shyan-shah/robot-penguin/CAD/renders/back.png

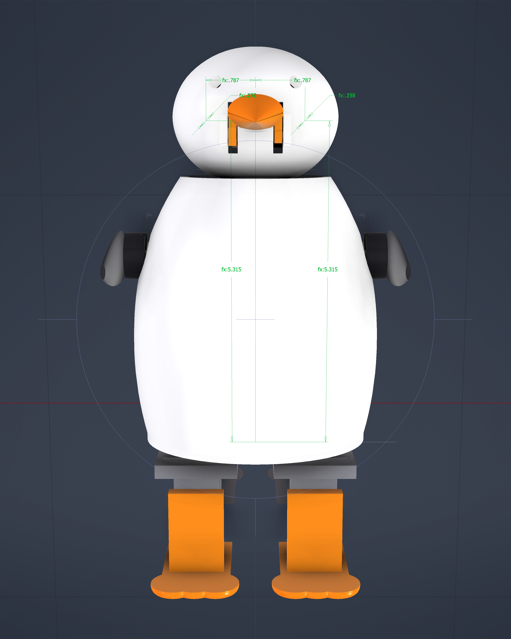
CAD/renders/back.png
