shyan-shah/robot-penguin/CAD/renders/base_plate_front.png

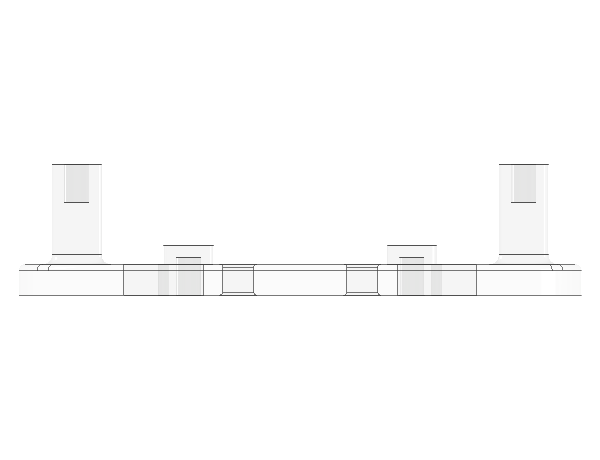
CAD/renders/base_plate_front.png
