shyan-shah/robot-penguin/CAD/renders/base_plate_iso.png

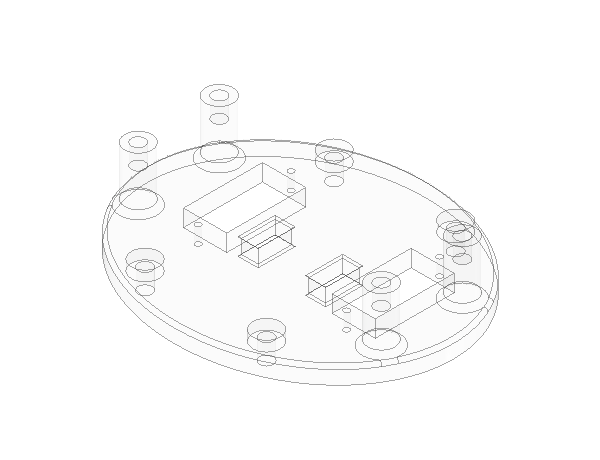
CAD/renders/base_plate_iso.png
