shyan-shah/robot-penguin/CAD/renders/base_plate_top.png

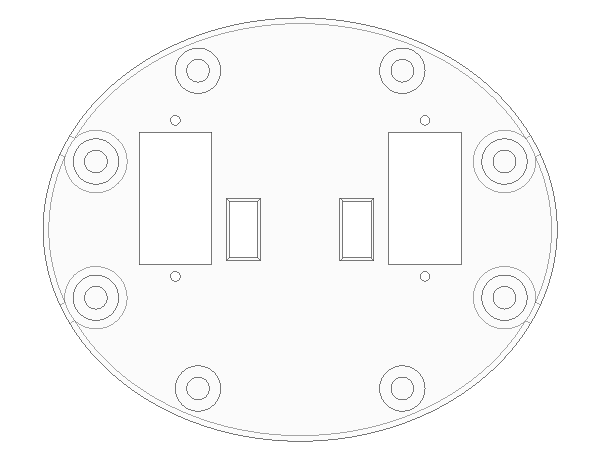
CAD/renders/base_plate_top.png
