shyan-shah/robot-penguin/CAD/renders/body_front_inside.png

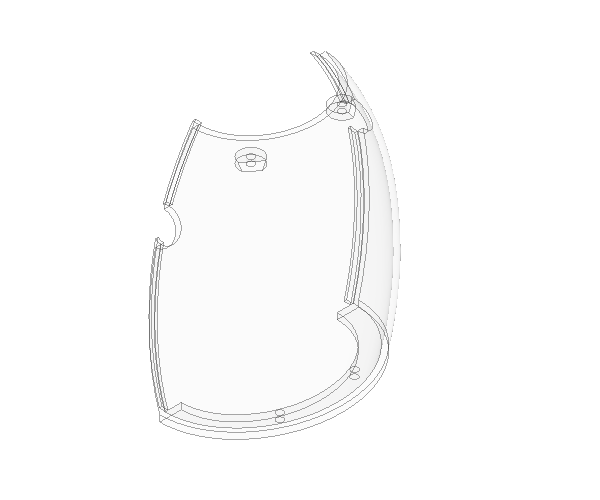
CAD/renders/body_front_inside.png
