shyan-shah/robot-penguin/CAD/renders/body_front_iso.png

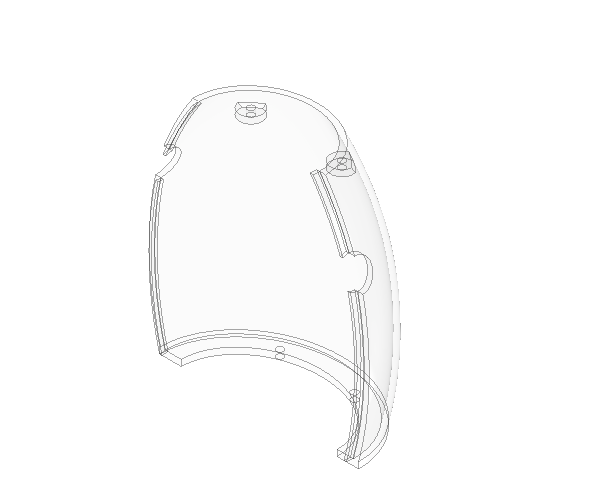
CAD/renders/body_front_iso.png
