shyan-shah/robot-penguin/CAD/renders/core_frame_front.png

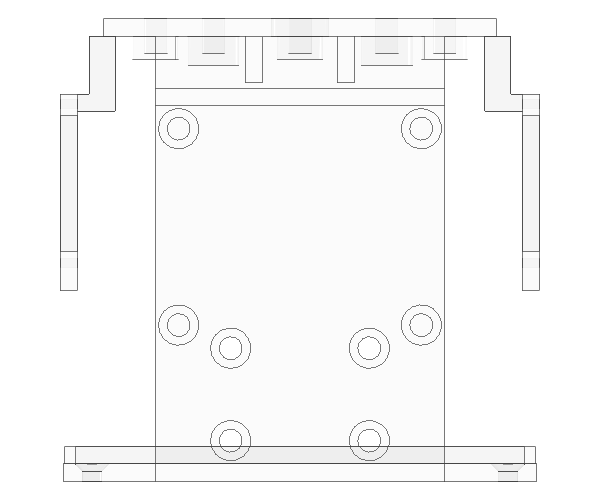
CAD/renders/core_frame_front.png
