shyan-shah/robot-penguin/CAD/renders/core_frame_iso.png

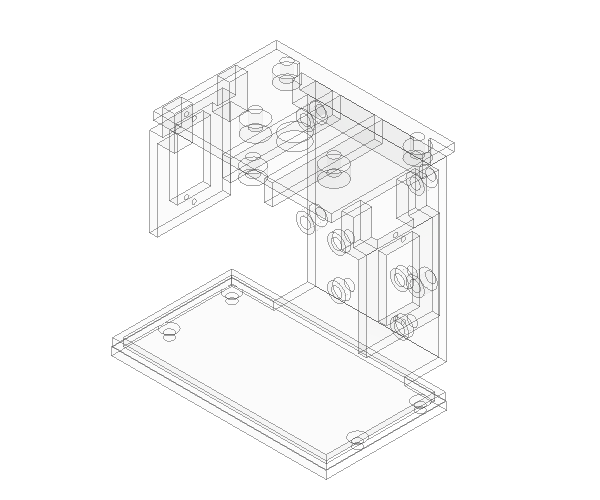
CAD/renders/core_frame_iso.png
