shyan-shah/robot-penguin/CAD/renders/core_frame_right.png

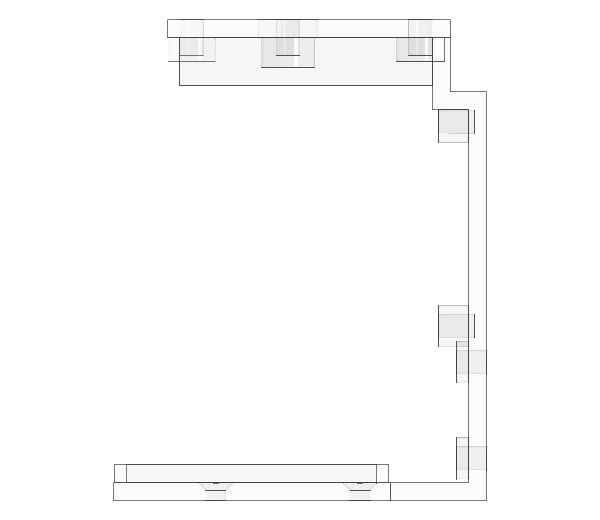
CAD/renders/core_frame_right.png
