shyan-shah/robot-penguin/CAD/renders/final_front.png

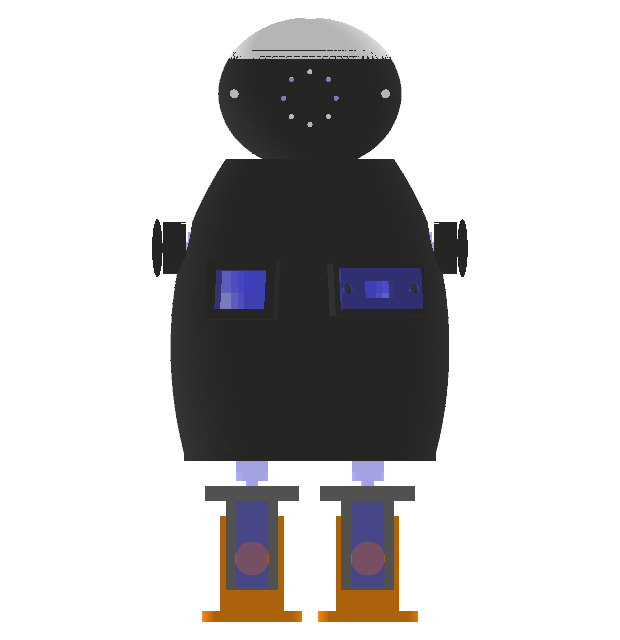
CAD/renders/final_front.png
