shyan-shah/robot-penguin/CAD/renders/final_iso.png

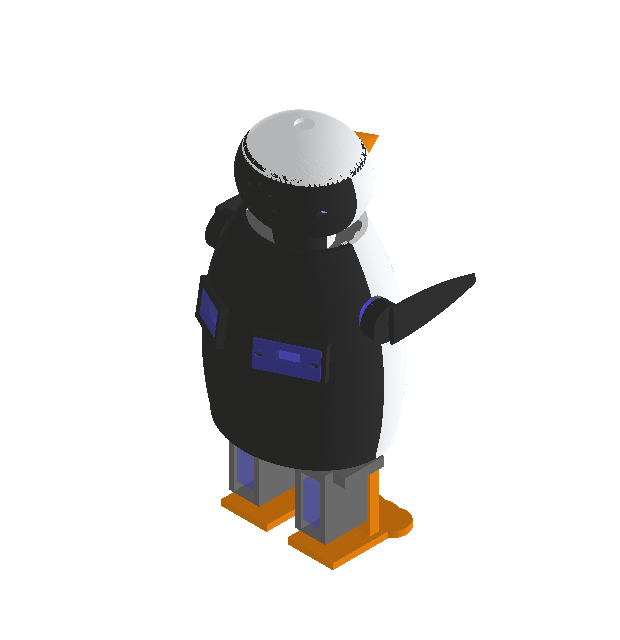
CAD/renders/final_iso.png
