shyan-shah/robot-penguin/CAD/renders/final_shells_off_iso.png

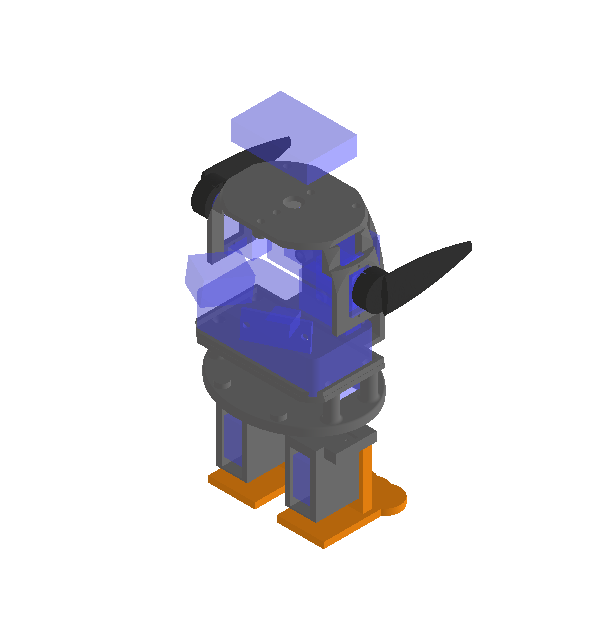
CAD/renders/final_shells_off_iso.png
