shyan-shah/robot-penguin/CAD/renders/final_side.png

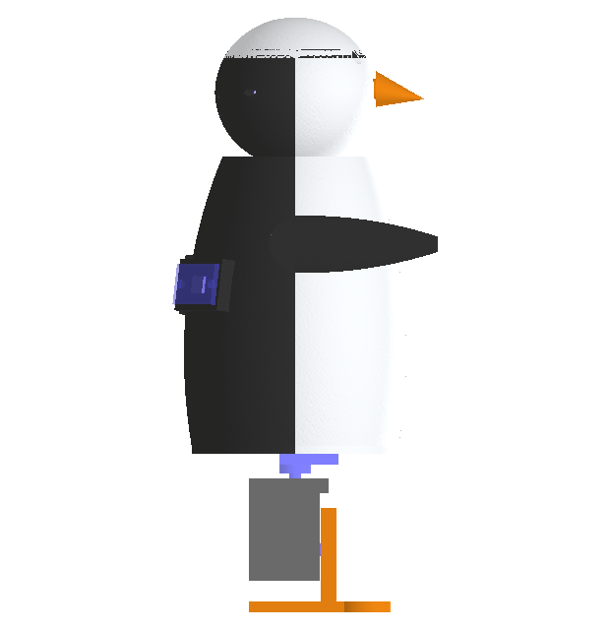
CAD/renders/final_side.png
