shyan-shah/robot-penguin/CAD/renders/front.png

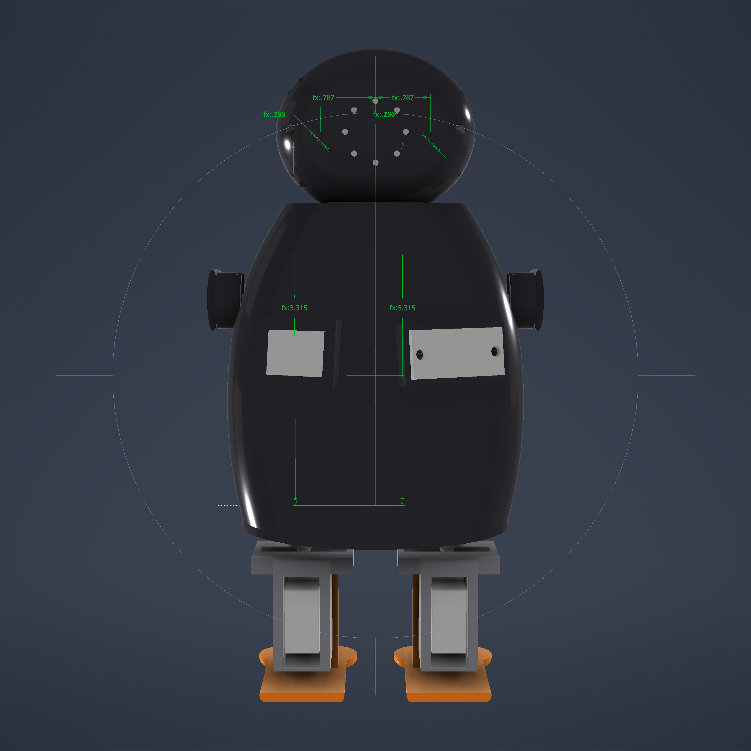
CAD/renders/front.png
