shyan-shah/robot-penguin/CAD/renders/hero_3q.png

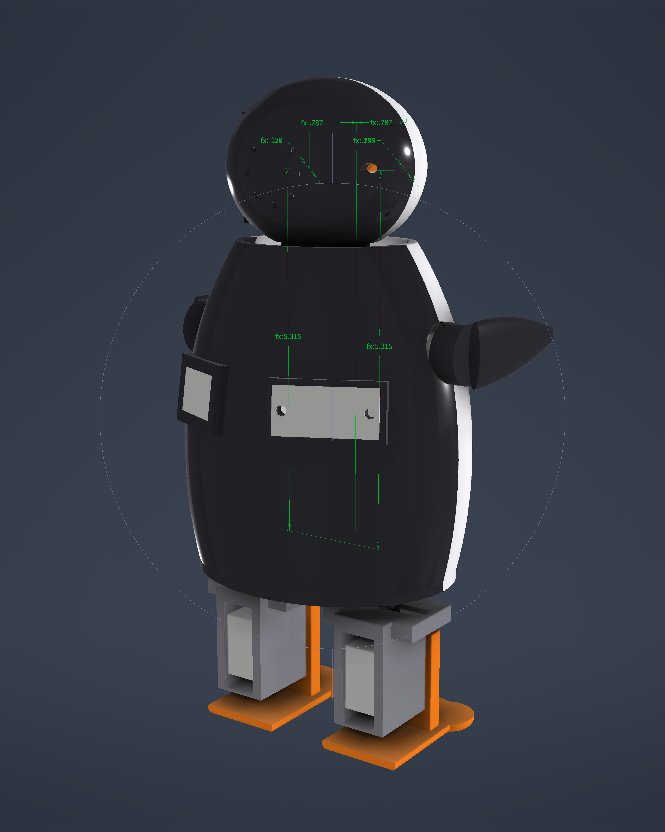
CAD/renders/hero_3q.png
