shyan-shah/robot-penguin/CAD/renders/hero_low.png

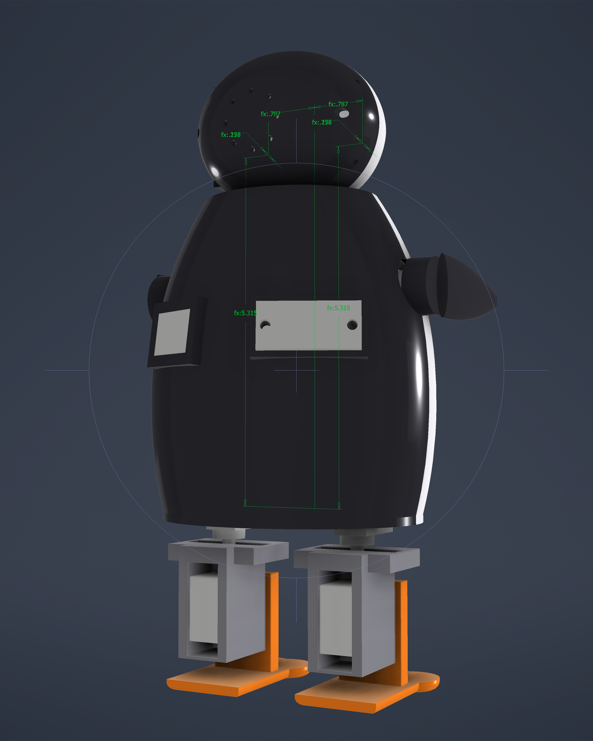
CAD/renders/hero_low.png
