shyan-shah/robot-penguin/CAD/renders/pose_bow_front.png

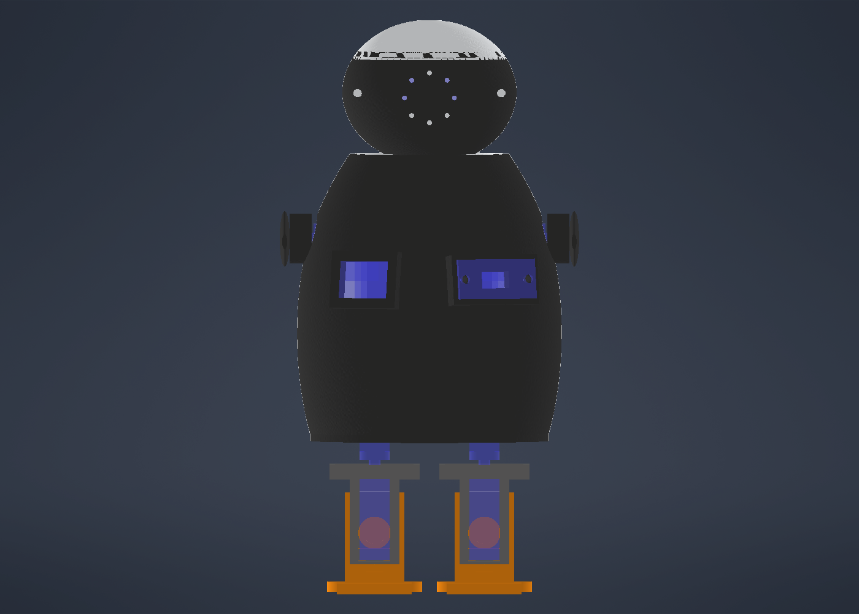
CAD/renders/pose_bow_front.png
