shyan-shah/robot-penguin/CAD/renders/pose_bow_iso.png

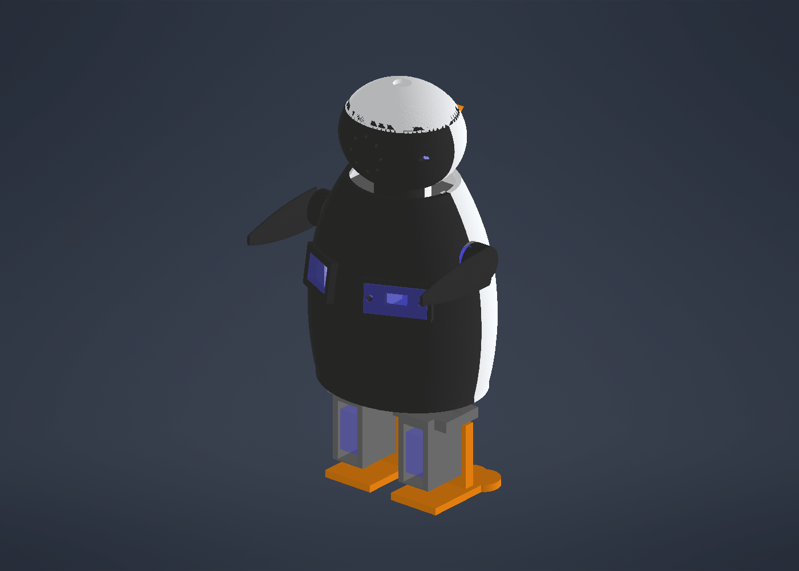
CAD/renders/pose_bow_iso.png
