shyan-shah/robot-penguin/CAD/renders/pose_neutral_side.png

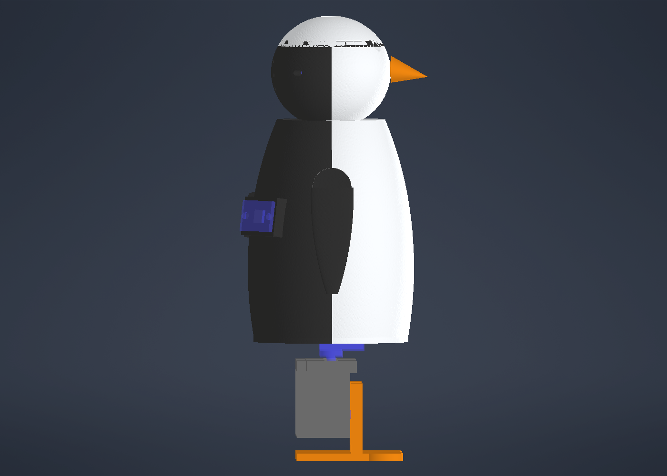
CAD/renders/pose_neutral_side.png
