shyan-shah/robot-penguin/CAD/renders/side.png

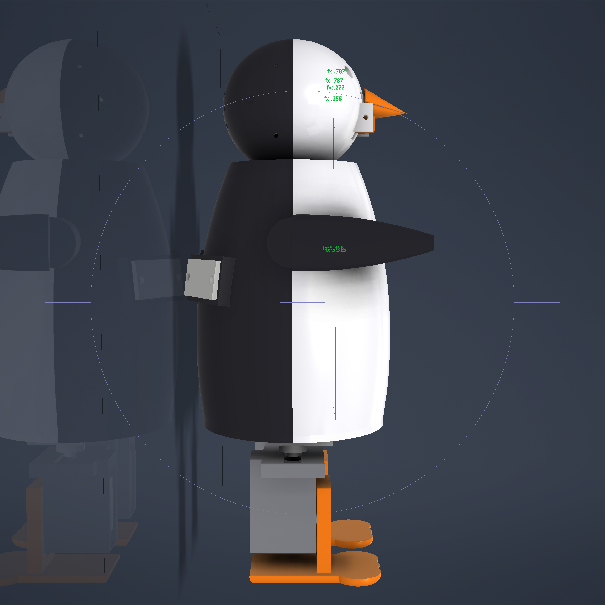
CAD/renders/side.png
