shyan-shah/robot-penguin/CAD/renders/story.png

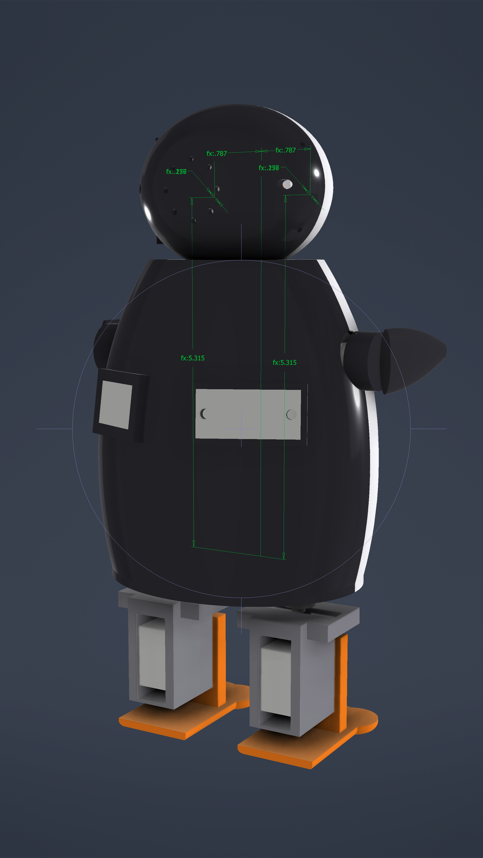
CAD/renders/story.png
