shyan-shah/robot-penguin/CAD/renders/three_q_L.png

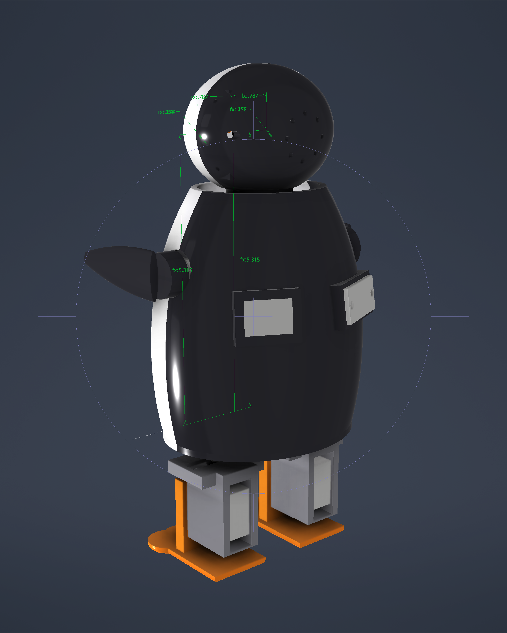
CAD/renders/three_q_L.png
