shyan-shah/robot-penguin/CAD/renders/top_down.png

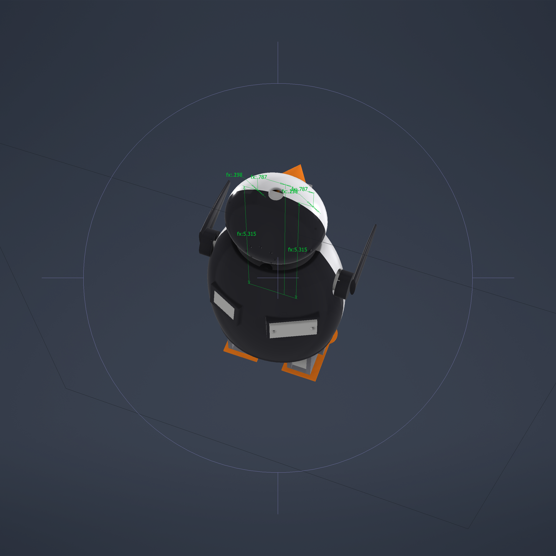
CAD/renders/top_down.png
