shyan-shah/robot-penguin/CAD/renders/v2_beak_closed.png

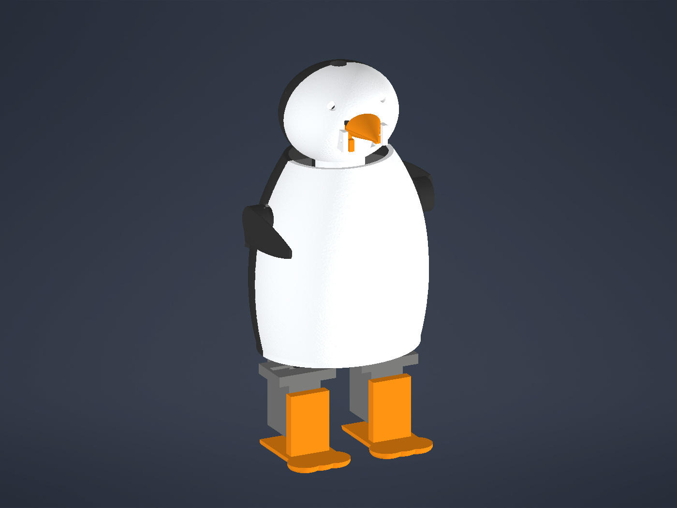
CAD/renders/v2_beak_closed.png
