shyan-shah/robot-penguin/CAD/renders/v2_front.png

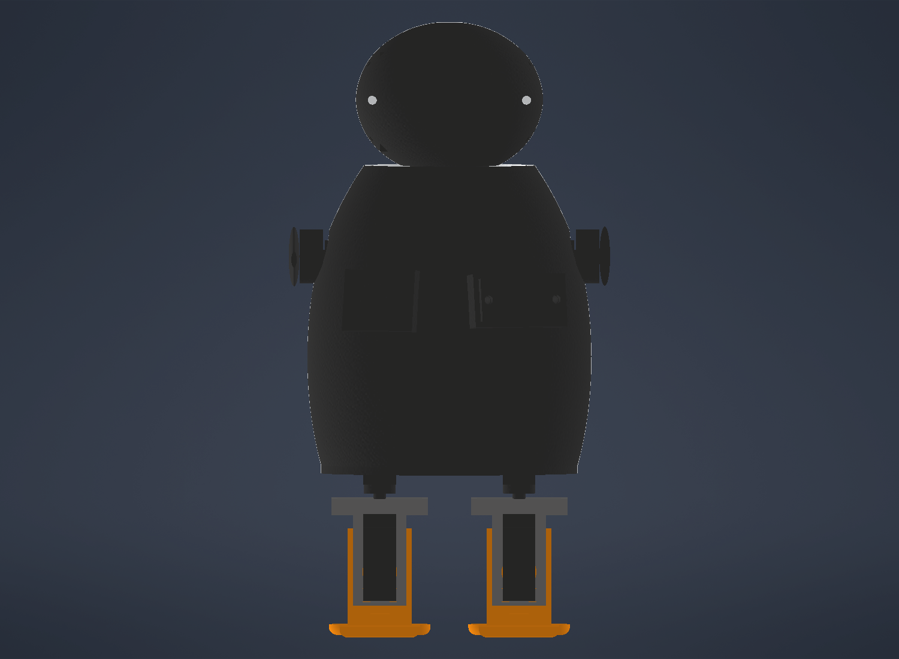
CAD/renders/v2_front.png
