shyan-shah/robot-penguin/CAD/renders/walk.gif

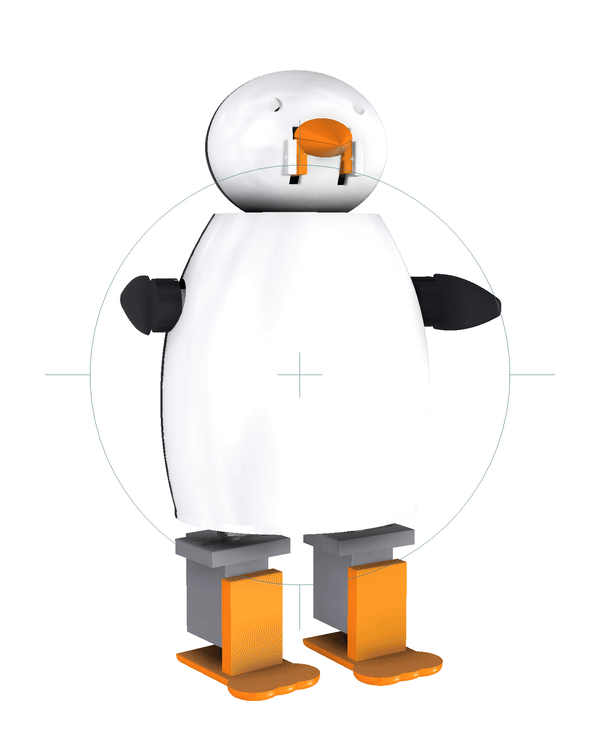
CAD/renders/walk.gif
