shyan-shah/robot-penguin/matlab/out/clearance.png

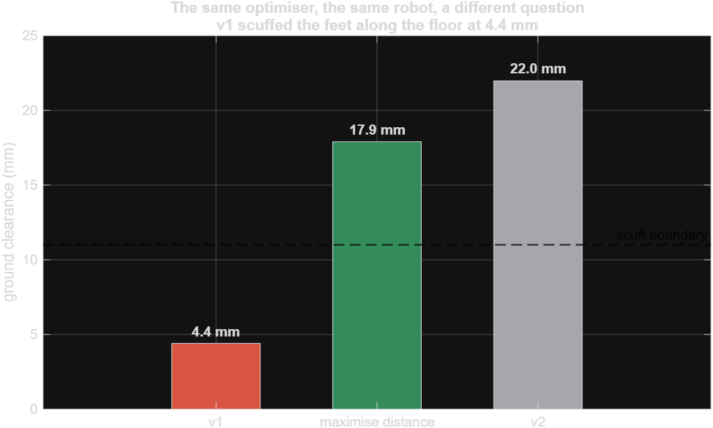
matlab/out/clearance.png
