shyan-shah/robot-penguin/matlab/out/gait_convergence.png

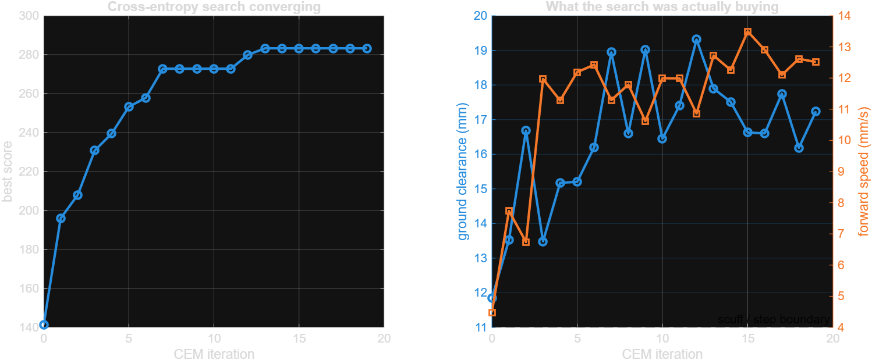
matlab/out/gait_convergence.png
