shyan-shah/robot-penguin/matlab/out/learning.png

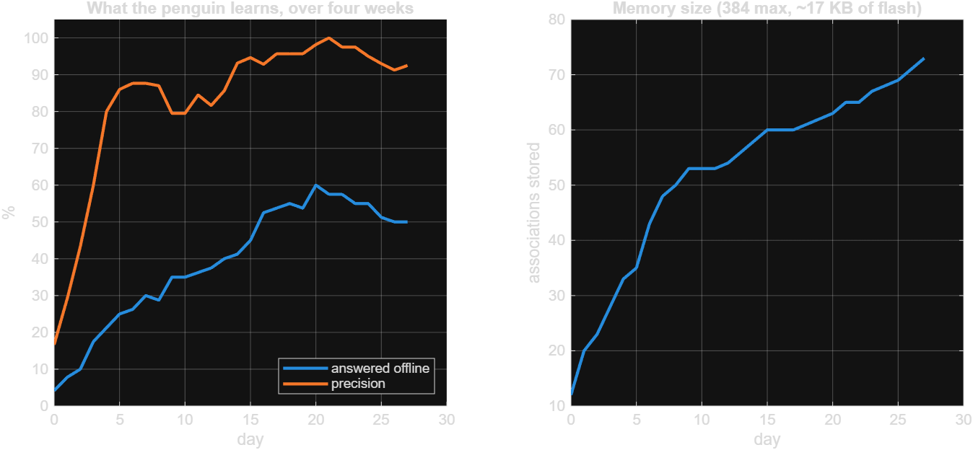
matlab/out/learning.png
