shyan-shah/robot-penguin/matlab/out/stability_map.png

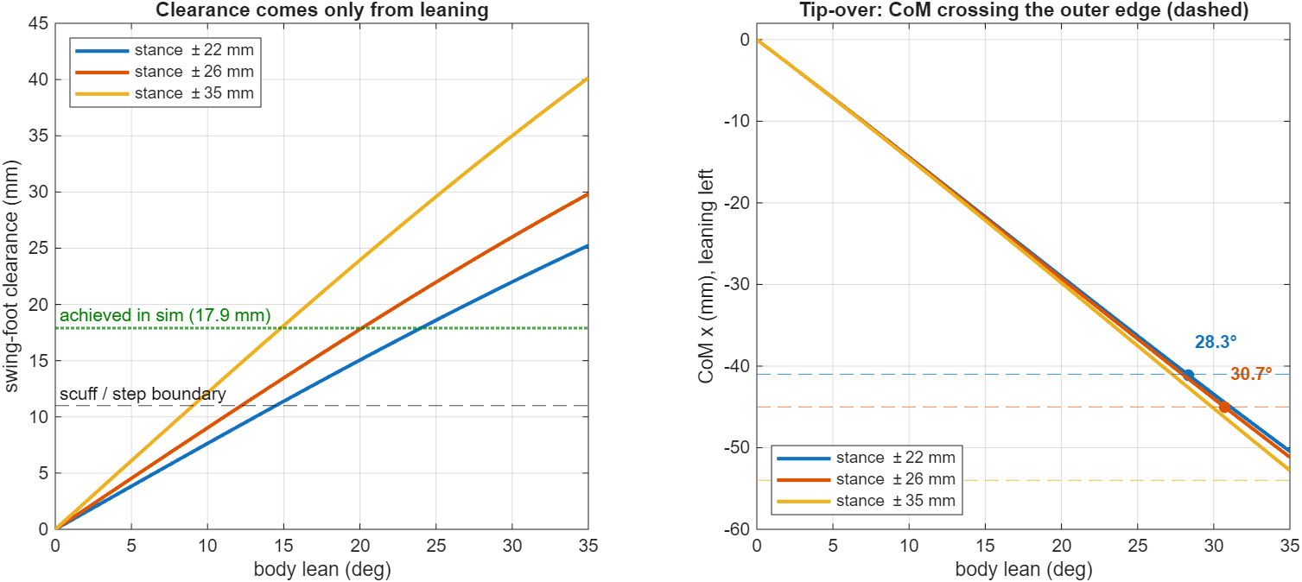
matlab/out/stability_map.png
