shyan-shah/robot-penguin/matlab/out/terrain.png

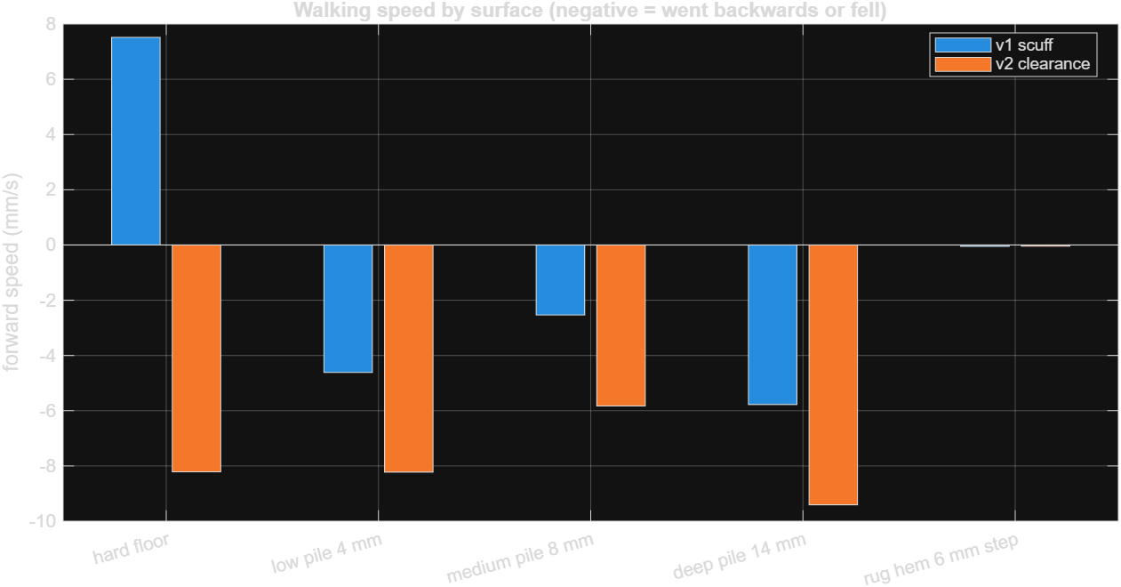
matlab/out/terrain.png
