shyan-shah/robot-penguin/CAD/exports/penguin.stp

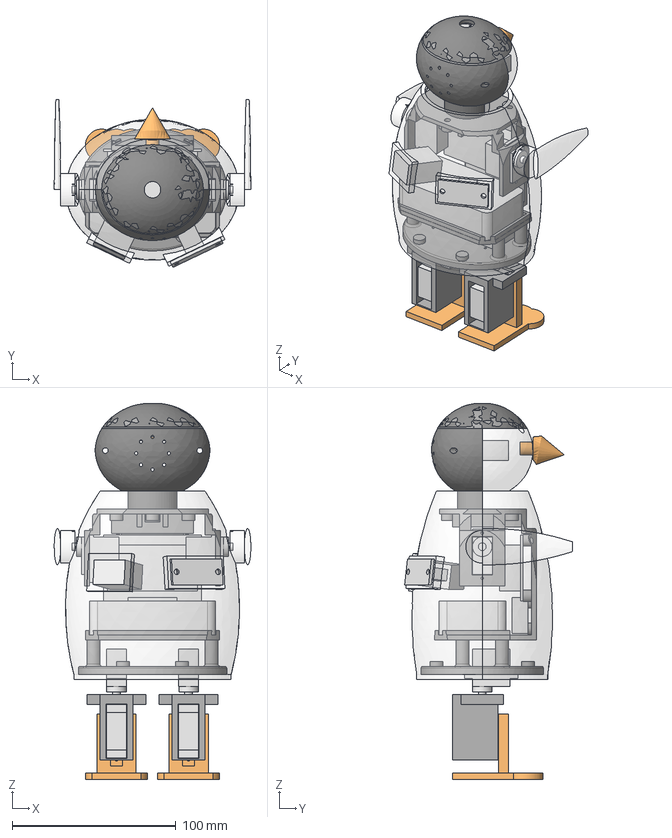
[picture p35: CAD file, 2026-10-30]
CAD/exports/penguin.stp
120.0 x 102.4 x 229.4 mm
DUMMY-MG90S x 6
DUMMY-BATT
DUMMY-PROTO
DUMMY-ESP32
DUMMY-BUCK
DUMMY-DF2301Q
DUMMY-KCD1
DUMMY-USB
PEN-001
PEN-002
PEN-003
PEN-004
PEN-005
PEN-006
PEN-007
PEN-008R
PEN-008L
PEN-009R
PEN-009L
PEN-010R
PEN-010L
