shyan-shah/robot-penguin/CAD/exports/stl_assembled/leg_L.stl

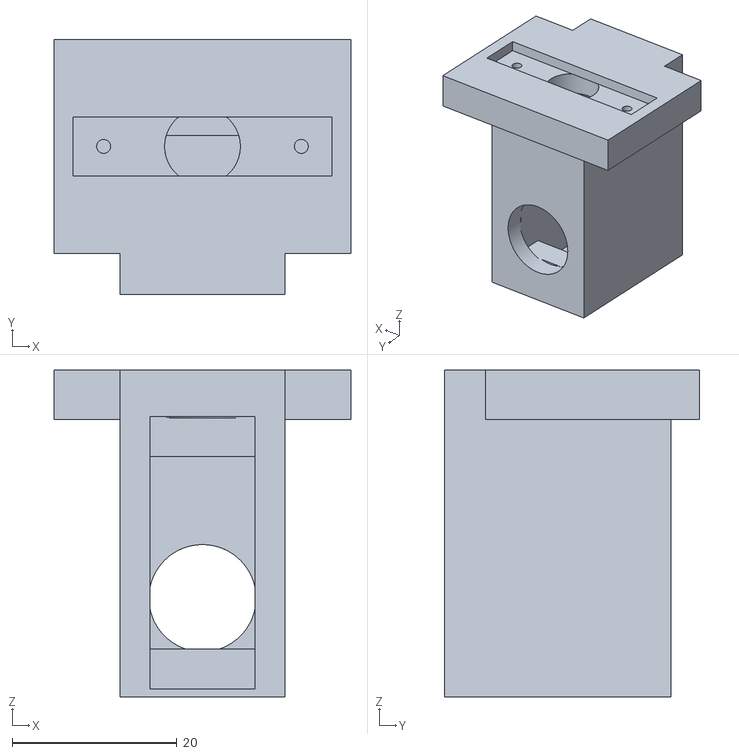
[picture p36: CAD file, 2026-10-30]
CAD/exports/stl_assembled/leg_L.stl
36.0 x 31.0 x 39.7
