shyan-shah/robot-penguin/CAD/exports/stl_assembled/core_frame.stl

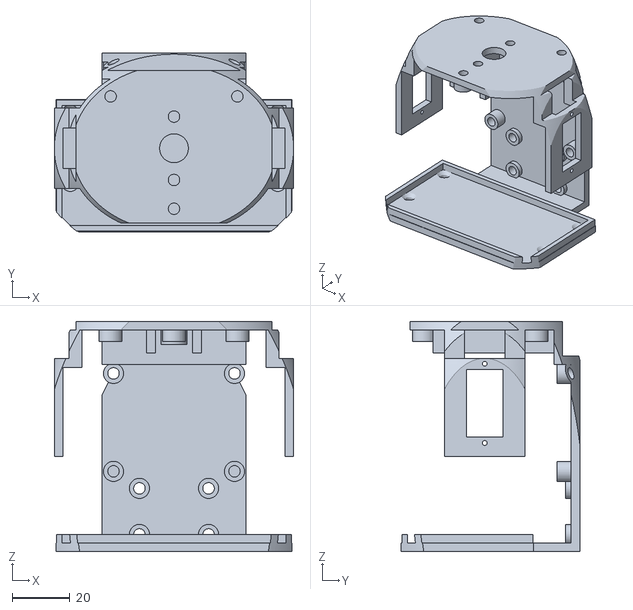
[picture p37: CAD file, 2026-10-30]
CAD/exports/stl_assembled/core_frame.stl
83.0 x 62.0 x 80.0
