shyan-shah/robot-penguin/CAD/exports/stl_assembled/foot_L.stl

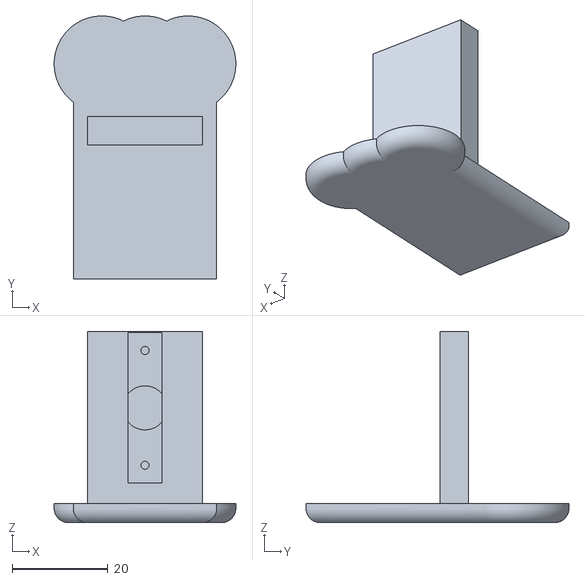
[picture p38: CAD file, 2026-10-30]
CAD/exports/stl_assembled/foot_L.stl
38.0 x 55.0 x 40.0
