shyan-shah/robot-penguin/CAD/exports/stl_assembled/base_plate.stl

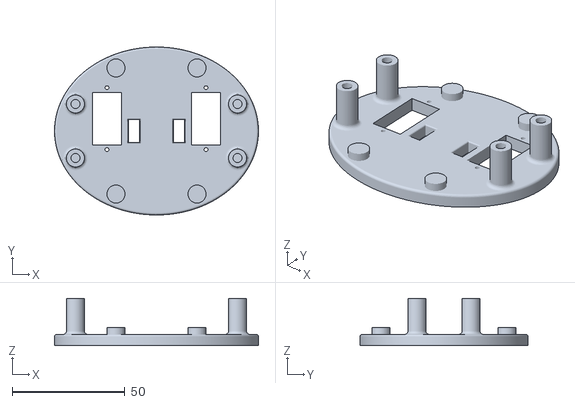
[picture p39: CAD file, 2026-10-30]
CAD/exports/stl_assembled/base_plate.stl
90.6 x 74.6 x 21.0
