shyan-shah/robot-penguin/CAD/exports/stl_assembled/beak_upper.stl

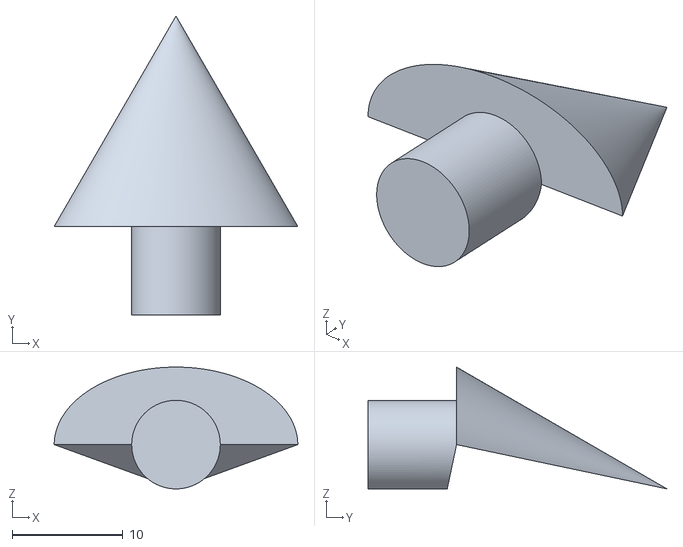
[picture p40: CAD file, 2026-10-30]
CAD/exports/stl_assembled/beak_upper.stl
22.0 x 27.0 x 11.0
