shyan-shah/robot-penguin/CAD/exports/stl_assembled/body_back.stl

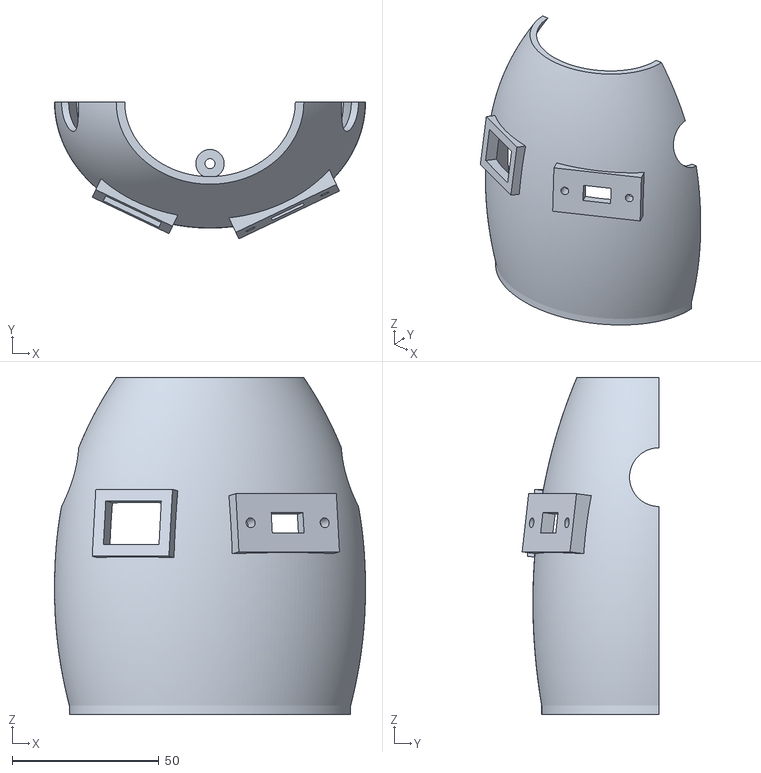
[picture p41: CAD file, 2026-10-30]
CAD/exports/stl_assembled/body_back.stl
106.1 x 46.7 x 115.0
