shyan-shah/robot-penguin/CAD/exports/stl_assembled/beak_lower.stl

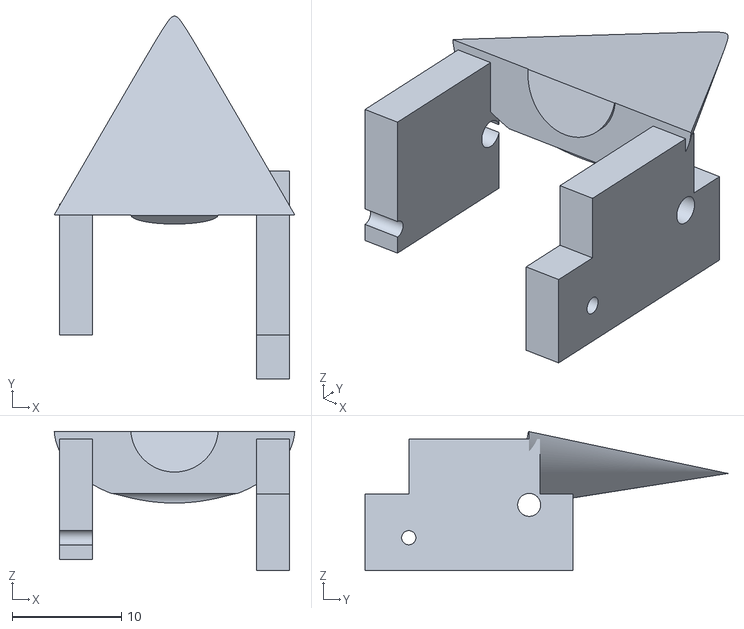
[picture p42: CAD file, 2026-10-30]
CAD/exports/stl_assembled/beak_lower.stl
22.0 x 33.2 x 12.7
