shyan-shah/robot-penguin/CAD/exports/stl_assembled/body_front.stl

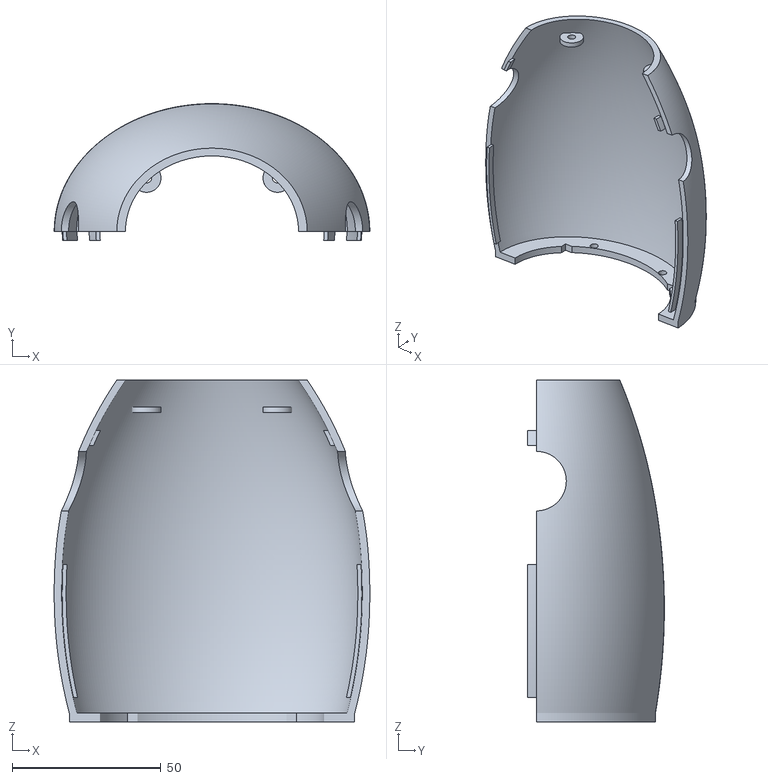
[picture p43: CAD file, 2026-10-30]
CAD/exports/stl_assembled/body_front.stl
106.1 x 46.0 x 115.0
