shyan-shah/robot-penguin/CAD/exports/stl_assembled/head_back.stl

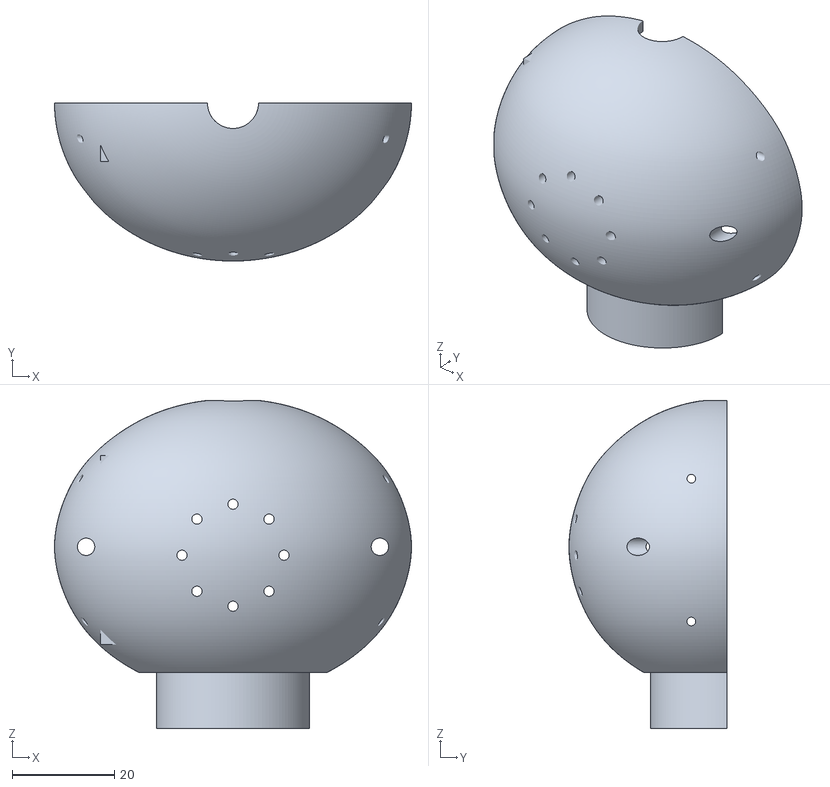
[picture p44: CAD file, 2026-10-30]
CAD/exports/stl_assembled/head_back.stl
70.0 x 31.0 x 64.4
