shyan-shah/robot-penguin/CAD/exports/stl_assembled/head_front.stl

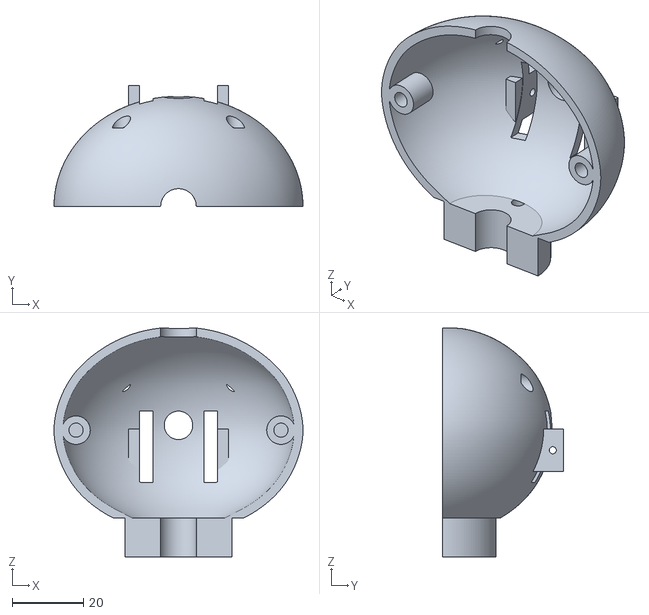
[picture p45: CAD file, 2026-10-30]
CAD/exports/stl_assembled/head_front.stl
70.0 x 34.0 x 64.4
