shyan-shah/robot-penguin/CAD/exports/stl_assembled/flipper_L.stl

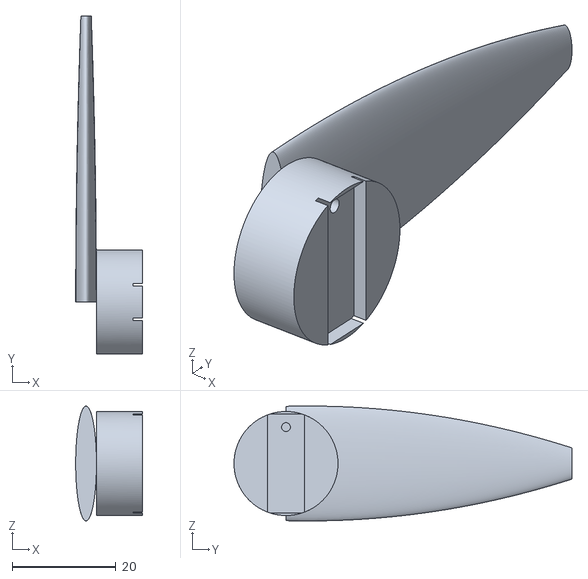
[picture p46: CAD file, 2026-10-30]
CAD/exports/stl_assembled/flipper_L.stl
12.8 x 65.0 x 22.1
