shyan-shah/robot-penguin/CAD/exports/stl/leg_L.stl

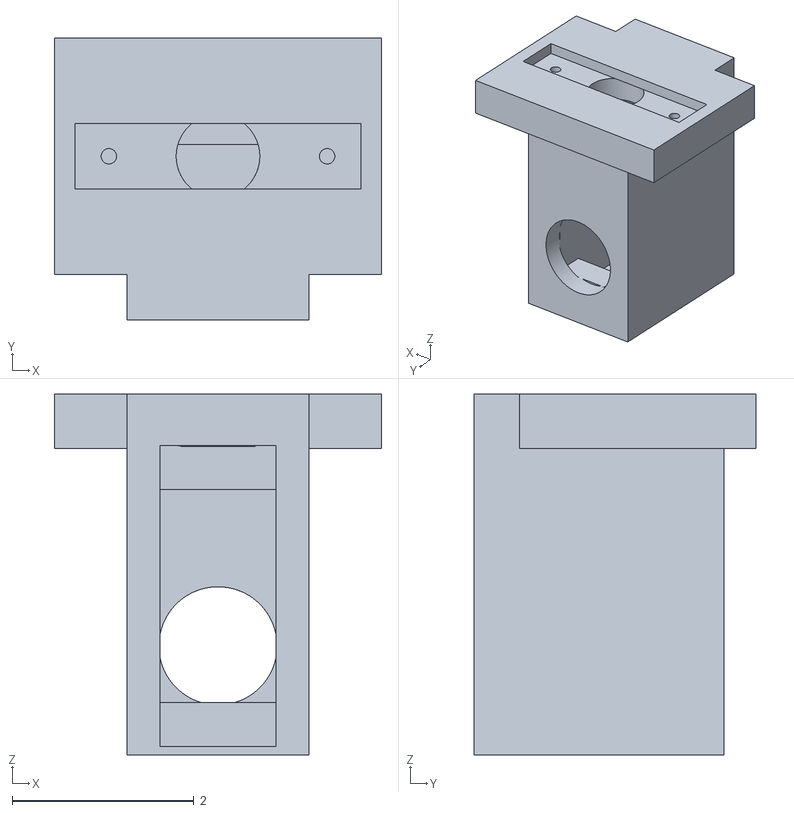
[picture p47: CAD file, 2026-10-30, an earlier design]
CAD/exports/stl/leg_L.stl
3.60 x 3.10 x 3.97
