shyan-shah/robot-penguin/CAD/exports/stl/foot_L.stl

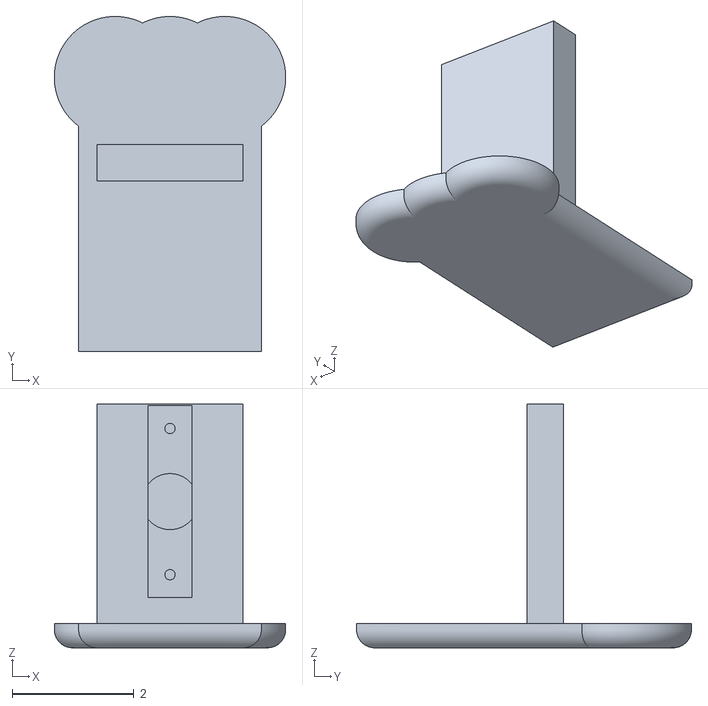
[picture p48: CAD file, 2026-10-30, an earlier design]
CAD/exports/stl/foot_L.stl
3.80 x 5.50 x 4.00
