shyan-shah/robot-penguin/CAD/exports/stl/flipper_L.stl

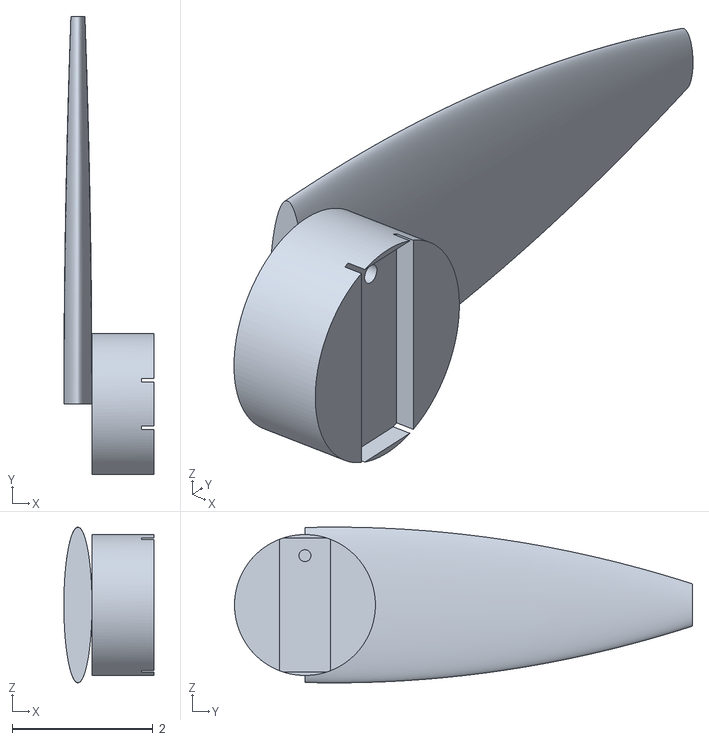
[picture p49: CAD file, 2026-10-30, an earlier design]
CAD/exports/stl/flipper_L.stl
1.28 x 6.50 x 2.21
