shyan-shah/robot-penguin/(list of files, cad)

Other CAD files:
CAD/exports/stl_assembled/leg_R.stl
CAD/exports/stl_assembled/foot_R.stl
CAD/exports/stl_assembled/flipper_R.stl
CAD/base_plate.ipt
CAD/beak.ipt
CAD/beak_lower.ipt
CAD/beak_upper.ipt
CAD/body_back.ipt
CAD/body_front.ipt
CAD/core_frame.ipt
CAD/dummies/dummy_battery_holder.ipt
CAD/dummies/dummy_buck.ipt
CAD/dummies/dummy_df2301q.ipt
CAD/dummies/dummy_esp32.ipt
CAD/dummies/dummy_i2s_amp.ipt
CAD/dummies/dummy_i2s_mic.ipt
CAD/dummies/dummy_protoboard.ipt
CAD/dummies/dummy_speaker23.ipt
CAD/dummies/dummy_switch.ipt
CAD/dummies/dummy_usb_socket.ipt
CAD/dummies/servo_mg90s_dummy.ipt
CAD/exports/penguin.stl
CAD/exports/stl/base_plate.stl
CAD/exports/stl/beak_lower.stl
CAD/exports/stl/beak_upper.stl
CAD/exports/stl/body_back.stl
CAD/exports/stl/body_front.stl
CAD/exports/stl/core_frame.stl
CAD/exports/stl/flipper_R.stl
CAD/exports/stl/foot_R.stl
CAD/exports/stl/head_back.stl
CAD/exports/stl/head_front.stl
CAD/exports/stl/leg_R.stl
CAD/exports/stl_print/base_plate.stl
CAD/exports/stl_print/beak_lower.stl
CAD/exports/stl_print/beak_upper.stl
CAD/exports/stl_print/body_back.stl
CAD/exports/stl_print/body_front.stl
CAD/exports/stl_print/core_frame.stl
CAD/exports/stl_print/flipper_L.stl
CAD/exports/stl_print/flipper_R.stl
CAD/exports/stl_print/foot_L.stl
CAD/exports/stl_print/foot_R.stl
CAD/exports/stl_print/head_back.stl
CAD/exports/stl_print/head_front.stl
CAD/exports/stl_print/leg_L.stl
CAD/exports/stl_print/leg_R.stl
CAD/flipper_L.ipt
CAD/flipper_R.ipt
CAD/foot_L.ipt
CAD/foot_R.ipt
CAD/head_back.ipt
CAD/head_front.ipt
CAD/leg_L.ipt
CAD/leg_R.ipt
CAD/penguin.iam
CAD/tail_prop.ipt
