shyan-shah/robot-penguin/CAD/renders/step0_skeleton_front.png

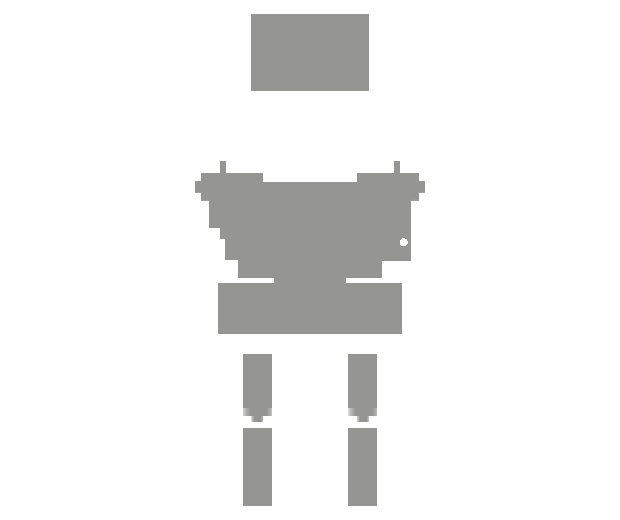
CAD/renders/step0_skeleton_front.png
