shyan-shah/robot-penguin/CAD/renders/step0_skeleton_iso.png

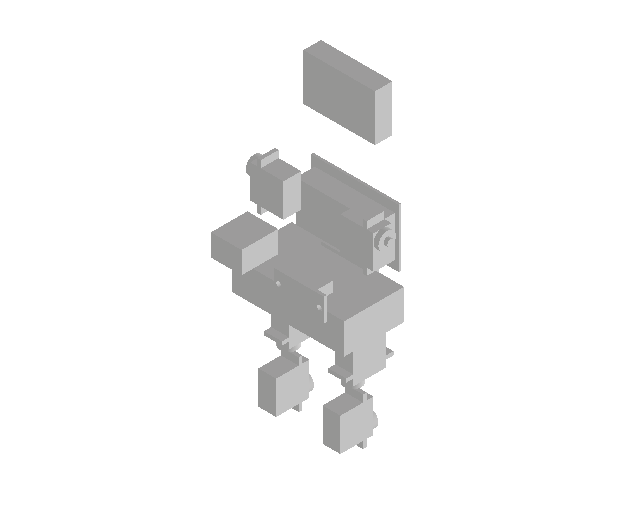
CAD/renders/step0_skeleton_iso.png
