shyan-shah/robot-penguin/CAD/renders/step0_skeleton_right.png

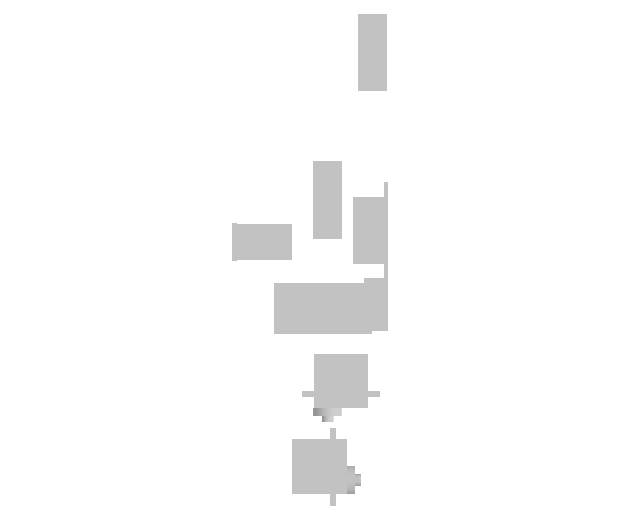
CAD/renders/step0_skeleton_right.png
