shyan-shah/robot-penguin/CAD/renders/step4_assembly_back.png

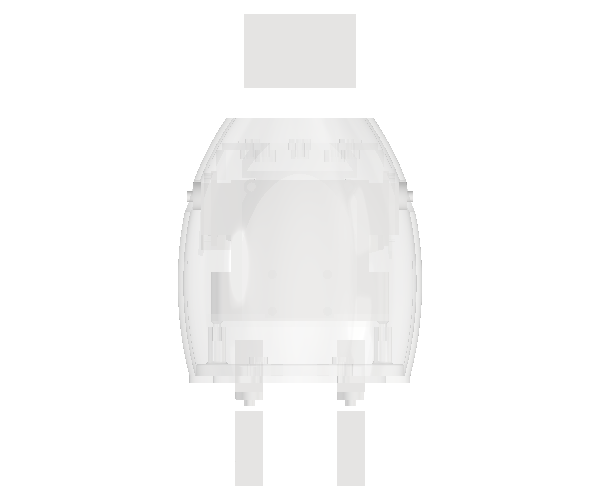
CAD/renders/step4_assembly_back.png
