shyan-shah/robot-penguin/(commit log)

2026-10-29 Code, simulation and documentation
    The robot penguin's software and design record: the PyBullet simulation and
    the parameter searches that tuned it, the host-side brain, the ESP32-S3
    firmware, the Simscape cross-check, and the full documentation set.
    CAD binaries, exports and renders follow in subsequent commits.
    [penguin.urdf, penguin_diag.urdf, penguin_params.xlsx, penguin_prop.urdf, penguin_verify.urdf]
2026-10-30 CAD: parametric Inventor parts and assembly
    [base_plate.ipt, beak.ipt, beak_lower.ipt, beak_upper.ipt, body_back.ipt, body_front.ipt, core_frame.ipt, dummy_battery_holder.ipt]
2026-10-30 CAD: print-ready STLs, STEP export and mass properties
    [base_plate.stl, beak_lower.stl, beak_upper.stl, body_back.stl, body_front.stl, core_frame.stl, flipper_L.stl, flipper_R.stl]
2026-10-30 CAD: raw STL exports
    [base_plate.stl, beak_lower.stl, beak_upper.stl, body_back.stl, body_front.stl, core_frame.stl, flipper_L.stl, flipper_R.stl]
2026-10-30 CAD: as-assembled STL exports
    [base_plate.stl, beak_lower.stl, beak_upper.stl, body_back.stl, body_front.stl, core_frame.stl, flipper_L.stl, flipper_R.stl]
2026-10-30 Renders: pose, assembly-step and development stills
2026-11-03 Shopping list: prices, and materials/colours per part
    Adds indicative UK prices in two columns (AliExpress vs UK stock) with
    subtotals and four build-cost scenarios, and a per-part material/colour
    table with solid and 20%-infill masses computed from the print STLs.
    Two things the numbers surfaced:
    - The feet are specified PETG but render orange, and orange PETG is both
    uncommon and only needed in 14 g. Noted to paint them rather than switch
    them to PLA, which would put PLA against the ankle servo.
    - Only three spools are needed, not five: the beak and feet together come to
    16 g of orange at 20% infill, so scrap or paint covers it.
    Also records that the built robot is ~425 g, not the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
2026-11-03 Single-material guidance, and uni filament pricing at 4p/g
    At 4p per gram the whole robot is £6.32 of plastic, so material choice is a
    mechanical decision rather than a cost one. Recommends printing everything in
    PETG: the robot cannot self-right and falls over by design, so impact
    resistance at the thin ankle and flipper sections matters more than shell
    finish, and the legs and frame hold servos that exceed PLA's glass transition
    under load.
    Also corrects a claim in BOM.md: PETG was specified for toughness and heat
    resistance, not stiffness. PLA is the stiffer of the two (~3.5 vs ~2.1 GPa);
    it is brittleness and creep that rule it out for the structural parts.
    Switching either way moves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
2026-11-03 Exact component quantities, order split, and an all-PETG print plan
    Separates what the robot USES from what to ORDER, which this page previously
    blurred. In doing so it caught a real under-order: the BOM uses 11 off M3 x 10
    (8 frame/shell plus 3 shell top tabs) while the shopping list said to order 10.
    Corrected to 15.
    Splits the list into penguin-specific parts that must be ordered and generic
    maker stock worth checking for first, which drops the build to ~GBP 75-95 if
    the generic lines are already on hand.
    Adds CAD/exports/stl_print/PRINT_PLAN.md: all-PETG settings, print order
    chosen so the parts everything locates off come first and a 15-minute test
    print comes before any long one, per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
2026-11-03 Support a classic ESP32 DevKitC as well as the S3
    The firmware needs seven PWM outputs and one I2C pair. It allocates nothing
    from PSRAM and owns no audio, so a classic ESP32 can run it -- but two things
    had to give, and both were found by the compiler rather than by reading:
    - RAM. The learning store is a fixed Assoc items_[384] and sizeof(Assoc) is
    304 bytes, so it is 114 KB: about 70% of the firmware's RAM. That fits the
    S3 at 50.9% but overflowed a classic ESP32's dram0_0_seg by 42,688 bytes.
    Capacity is now 384 on the S3 and 224 on a classic. Safe because the blob
    format does not record capacity and load() stops at PGM_MAX_ITEMS, so an
    S3-written file loads its first 224 with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
    [learning.h, main.cpp]
2026-11-03 Order Ruthex inserts rather than risk a mismatched profile
    The bosses are modelled to the Ruthex M3 4.0 x 6 profile specifically, and a
    Rx4.6 or Rx5.0 insert either will not seat or will split the boss. GBP 8-10 for
    100 is cheaper than reprinting a core_frame, so the inserts move from
    'measure first' to the order.
    Adds a 15-line basket totalling ~GBP 70 budget / ~GBP 109 UK stock, and
    reconciles the scenario table to those figures.
2026-11-03 Print plan: per-part colour and infill
    Splits the documented 20-25% gyroid by what each part does: 25% for
    core_frame, base_plate, legs and feet, which carry load, hold servos and take
    landing impacts, and 20% for the shells, which are cosmetic and large enough
    that lower infill actually saves something. Small parts stay at 25% because
    infill barely moves their mass.
    Adds colour and quantity columns so the table is enough to hand to a print
    service. ~171 g total, GBP 6.84 at 4p/g.
